Ecognize/uavprobe/hw/uavprobe/uavprobe.kicad_pcb

## KiCad design hw/uavprobe/uavprobe.kicad_pcb (2025-10-03)

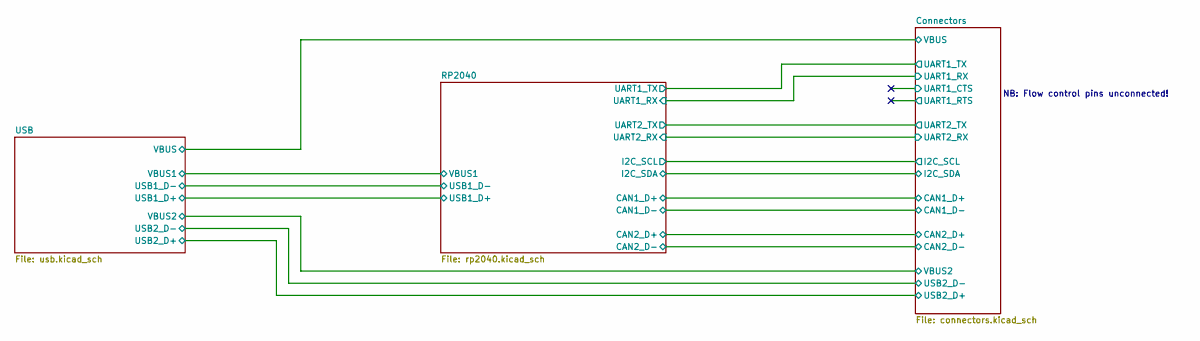
[picture p1: schematic uavprobe.kicad_sch, UAV Sensor Probe]

Notes on the sheet:
NB: Flow control pins unconnected!

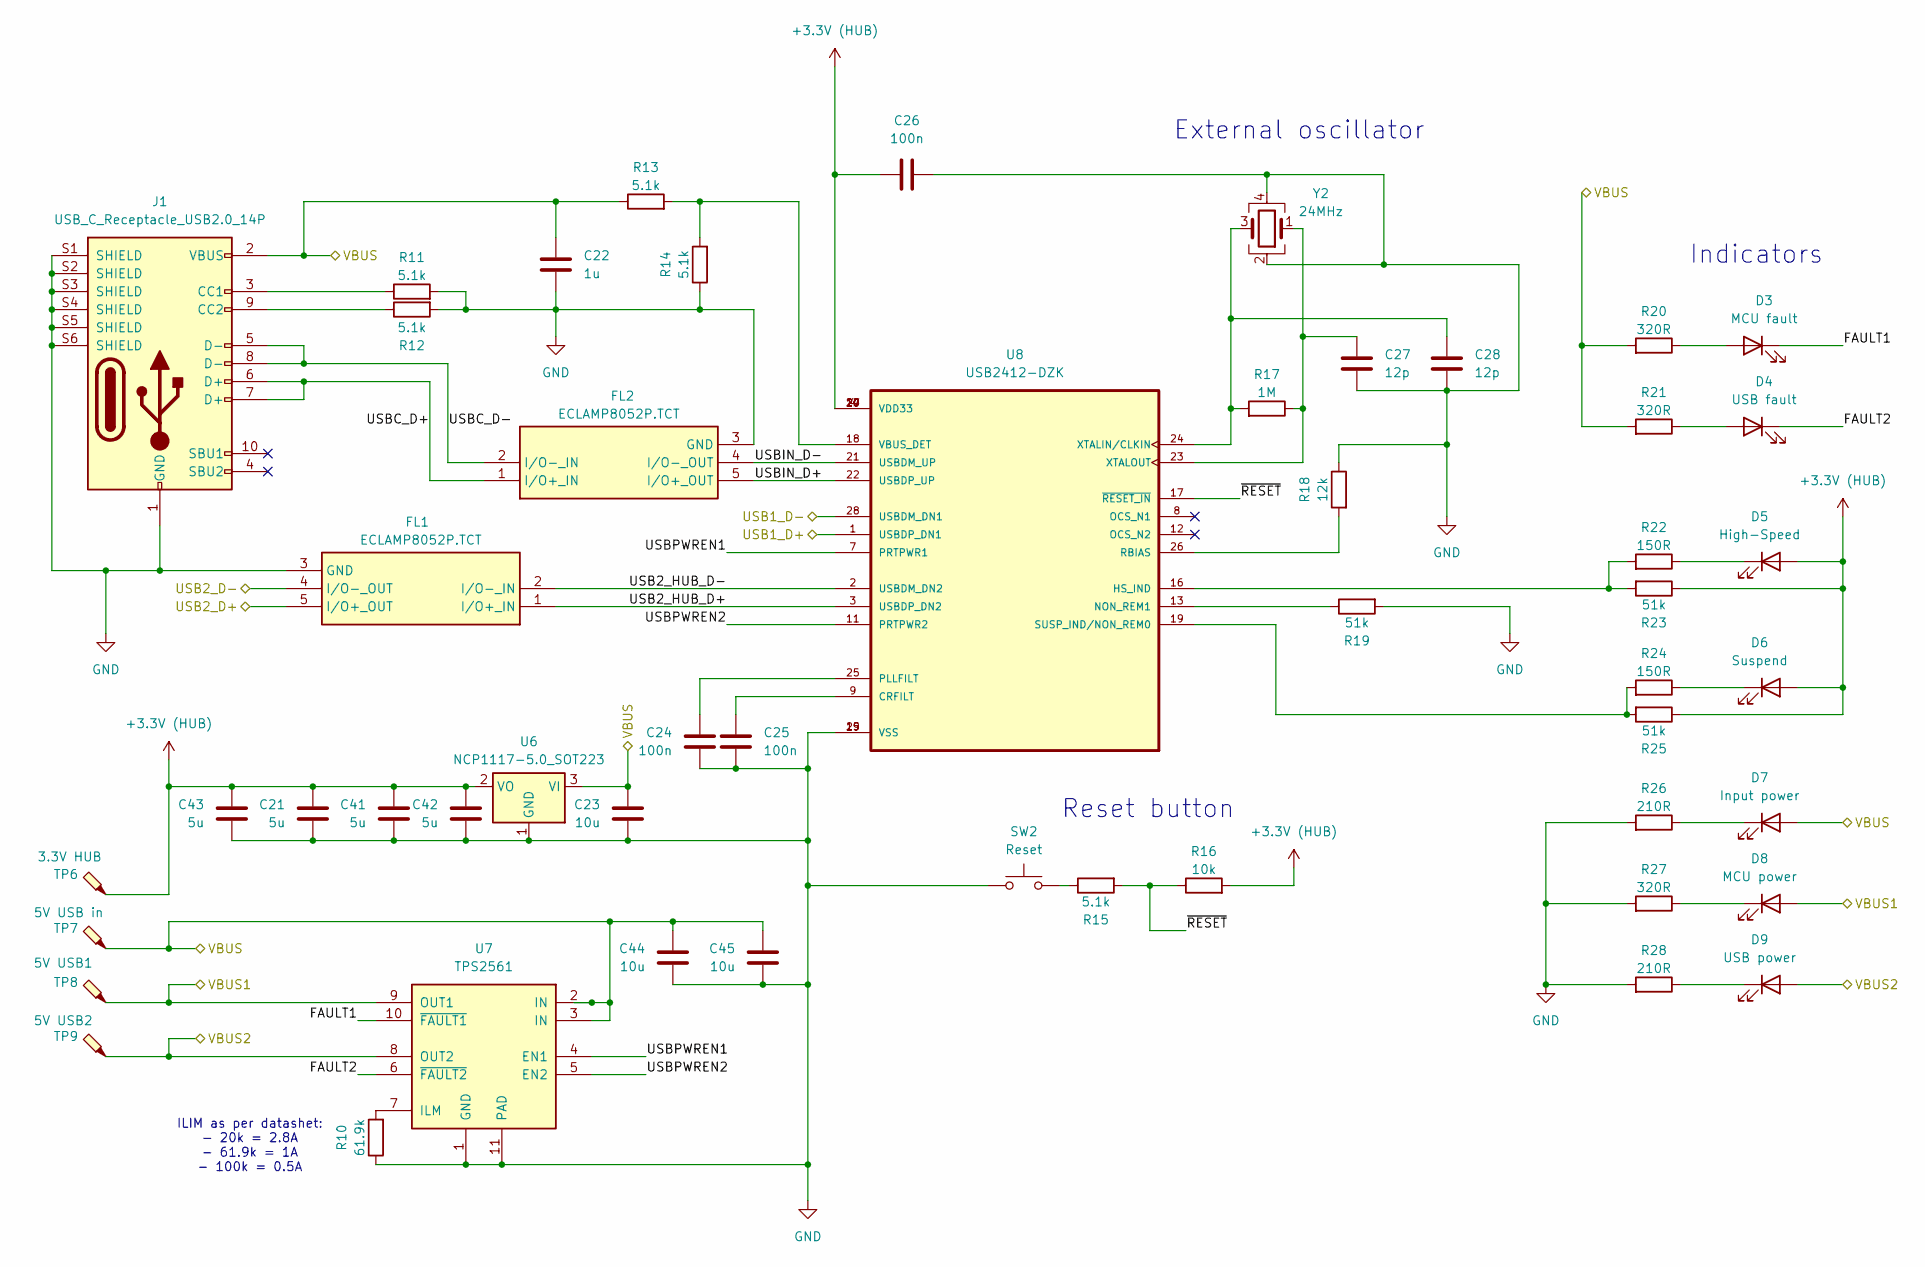
[picture p2: schematic usb.kicad_sch, UAV Sensor Probe]

Parts:
C21, C41, C42, C43: 5u; C_0402_1005Metric
C22: 1u; C_0402_1005Metric
C23, C44, C45: 10u; C_0402_1005Metric
C24, C25, C26: 100n; C_0402_1005Metric
C27, C28: 12p; C_0402_1005Metric
D3: MCU fault; LED_0402_1005Metric; MPN QBLP595-R
D4: USB fault; LED_0402_1005Metric; MPN QBLP595-R
D5: High-Speed; LED_0402_1005Metric; MPN QBLP595-O
D6: Suspend; LED_0402_1005Metric; MPN QBLP595-Y
D7: Input power; LED_0402_1005Metric; MPN QBLP595-IG
D8: MCU power; LED_0402_1005Metric; MPN QBLP595-AG
D9: USB power; LED_0402_1005Metric; MPN QBLP595-IB
FL1, FL2: ECLAMP8052P.TCT; ECLAMP8052PTCT; MPN ECLAMP8052P.TCT; Mouser Part Number 947-ECLAMP8052P.TCT
J1: USB_C_Receptacle_USB2.0_14P; JAE_DX07S016JA1R1500; MPN DX07S016JA1R1500
R10: 61.9k; R_0402_1005Metric
R11, R12, R13, R14, R15: 5.1k; R_0402_1005Metric
R16: 10k; R_0402_1005Metric
R17: 1M; R_0402_1005Metric
R18: 12k; R_0402_1005Metric
R19, R23, R25: 51k; R_0402_1005Metric
R20, R21, R27: 320R; R_0402_1005Metric
R22, R24: 150R; R_0402_1005Metric
R26, R28: 210R; R_0402_1005Metric
SW2: Reset; SW_SPST_B3U-1000P; MPN B3U-1000PM
TP6: 3.3V HUB; TestPoint_Pad_D1.5mm
TP7: 5V USB in; TestPoint_Pad_D1.5mm
TP8: 5V USB1; TestPoint_Pad_D1.5mm
TP9: 5V USB2; TestPoint_Pad_D1.5mm
U6: NCP1117-5.0_SOT223; SOT-223-3_TabPin2; MPN NCP1117ST33T3G
U7: TPS2561; VSON-10-1EP_3x3mm_P0.5mm_EP1.65x2.4mm_ThermalVias; MPN TPS2561DRCT
U8: USB2412-DZK; QFN50P500X500X100-29N; MPN USB2412-DZK; DIGI-KEY_PART_NUMBER 638-1114-ND
Y2: 24MHz; Crystal_SMD_Abracon_ABM3B-4Pin_5.0x3.2mm; MPN ABM3B-24.000MHZ-10-1-U-T

Connections:
+3.3V (HUB): C21.1, C26.1, C41.1, C42.1, C43.1, D5.2 (A), D6.2 (A), R16.2, R23.1, R25.1, TP6.1, U6.2 (VO), U8.4 (VDD33), U8.10 (VDD33), U8.14 (VDD33), U8.20 (VDD33), U8.27 (VDD33)
/Connectors/USB2_D+: FL1.5 (I/O+_OUT); also elsewhere on the board
/Connectors/USB2_D-: FL1.4 (I/O-_OUT); also elsewhere on the board
/Connectors/VBUS: C22.1, C23.1, C44.1, C45.1, D7.2 (A), J1.2 (VBUS), J1.11 (VBUS), R13.1, R20.2, R21.2, TP7.1, U6.3 (VI), U7.2 (IN), U7.3 (IN); also elsewhere on the board
/Connectors/VBUS2: D9.2 (A), TP9.1, U7.8 (OUT2); also elsewhere on the board
/RP2040/USB1_D+: U8.1 (USBDP_DN1); also elsewhere on the board
/RP2040/USB1_D-: U8.28 (USBDM_DN1); also elsewhere on the board
/RP2040/VBUS1: D8.2 (A), TP8.1, U7.9 (OUT1); also elsewhere on the board
/USB/FAULT1: D3.1 (K), U7.10 (~FAULT1)
/USB/FAULT2: D4.1 (K), U7.6 (~FAULT2)
/USB/USB2_HUB_D+: FL1.1 (I/O+_IN), U8.3 (USBDP_DN2)
/USB/USB2_HUB_D-: FL1.2 (I/O-_IN), U8.2 (USBDM_DN2)
/USB/USBC_D+: FL2.1 (I/O+_IN), J1.6 (D+), J1.7 (D+)
/USB/USBC_D-: FL2.2 (I/O-_IN), J1.5 (D-), J1.8 (D-)
/USB/USBIN_D+: FL2.5 (I/O+_OUT), U8.22 (USBDP_UP)
/USB/USBIN_D-: FL2.4 (I/O-_OUT), U8.21 (USBDM_UP)
/USB/USBPWREN1: U7.4 (EN1), U8.7 (PRTPWR1)
/USB/USBPWREN2: U7.5 (EN2), U8.11 (PRTPWR2)
/USB/~RESET: R15.2, R16.1, U8.17 (~RESET_IN)
GND: C21.2, C22.2, C23.2, C24.2, C25.2, C26.2, C27.2, C28.2, C41.2, C42.2, C43.2, C44.2, C45.2, FL1.3 (GND), FL2.3 (GND), J1.1 (GND), J1.12 (GND), J1.S1 (SHIELD), J1.S2 (SHIELD), J1.S3 (SHIELD), J1.S4 (SHIELD), J1.S5 (SHIELD), J1.S6 (SHIELD), R10.1, R11.2, R12.2, R14.1, R18.1, R19.2, R26.2, R27.2, R28.2, SW2.1, U6.1 (GND), U7.1 (GND), U7.11 (PAD), U8.15 (VSS), U8.29 (VSS), Y2.2, Y2.4; also elsewhere on the board
unnamed: D3.2 (A), R20.1
unnamed: D4.2 (A), R21.1
unnamed: D5.1 (K), R22.1
unnamed: D6.1 (K), R24.1
unnamed: D7.1 (K), R26.1
unnamed: D8.1 (K), R27.1
unnamed: D9.1 (K), R28.1
unnamed: J1.3 (CC1), R11.1
unnamed: J1.9 (CC2), R12.1
unnamed: R15.1, SW2.2
unnamed: R10.2, U7.7 (ILM)
unnamed: C25.1, U8.9 (CRFILT)
unnamed: R22.2, R23.2, U8.16 (HS_IND)
unnamed: R19.1, U8.13 (NON_REM1)
unnamed: C24.1, U8.25 (PLLFILT)
unnamed: R18.2, U8.26 (RBIAS)
unnamed: R24.2, R25.2, U8.19 (SUSP_IND/NON_REM0)
unnamed: R13.2, R14.2, U8.18 (VBUS_DET)
unnamed: C28.1, R17.2, U8.24 (XTALIN/CLKIN), Y2.3
unnamed: C27.1, R17.1, U8.23 (XTALOUT), Y2.1

Notes on the sheet:
Indicators
ILIM as per datashet: - 20k = 2.8A - 61.9k = 1A - 100k = 0.5A
Reset button
External oscillator

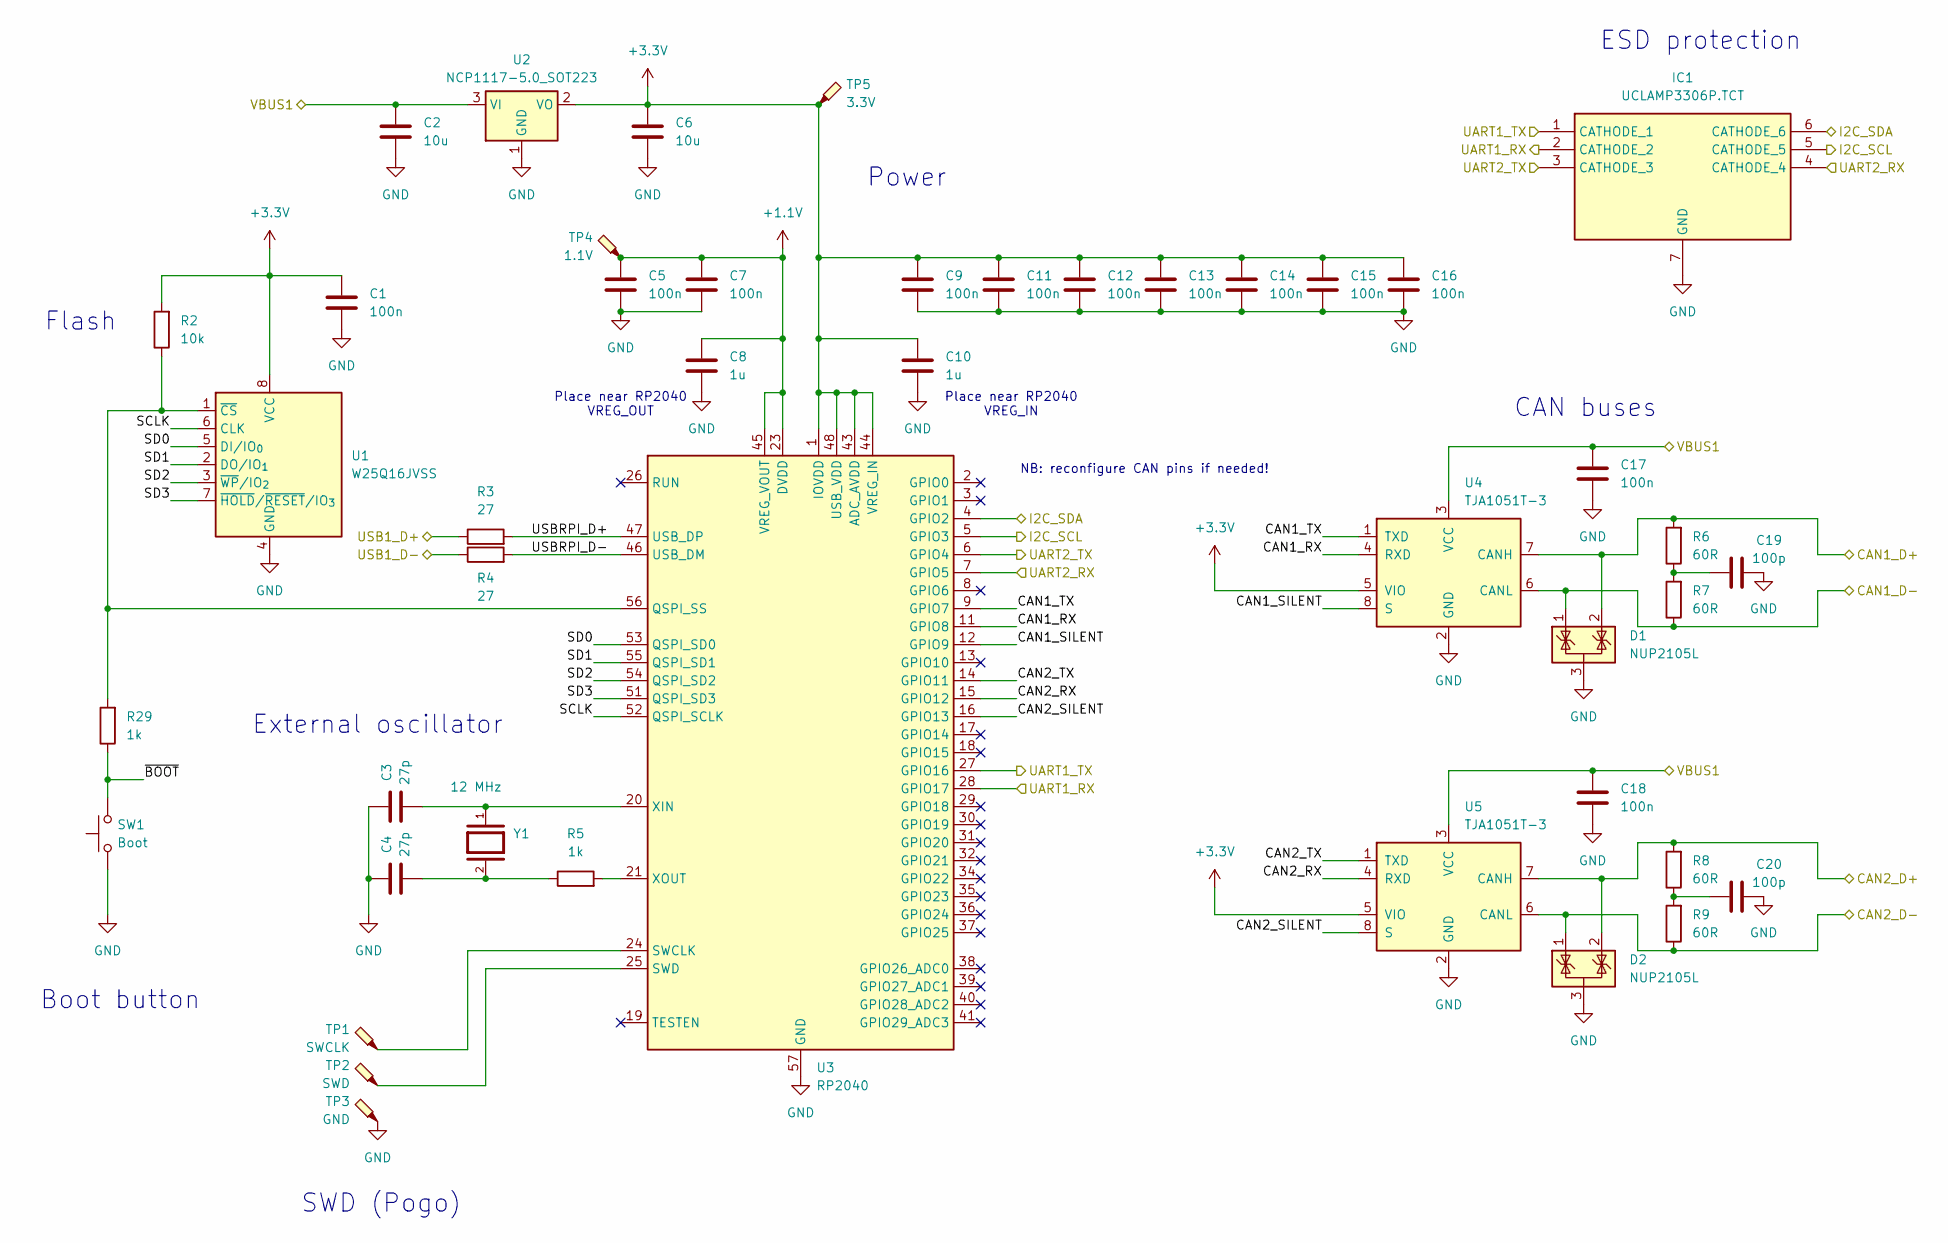
[picture p3: schematic rp2040.kicad_sch, UAV Sensor Probe]

Parts:
C1, C5, C7, C9, C11, C12, C13, C14, C15, C16, C17, C18: 100n; C_0402_1005Metric
C2, C6: 10u; C_0402_1005Metric
C3, C4: 27p; C_0402_1005Metric
C8, C10: 1u; C_0402_1005Metric
C19, C20: 100p; C_0402_1005Metric
D1, D2: NUP2105L; SOT-23; MPN NUP2105L
IC1: UCLAMP3306P.TCT; SON50P160X160X65-7N; MPN UCLAMP3306P.TCT; Mouser Part Number 947-UCLAMP3306P.TCT
R2: 10k; R_0402_1005Metric
R3: 27; R_0603_1608Metric
R4: 27; R_0402_1005Metric
R5, R29: 1k; R_0402_1005Metric
R6, R7, R8, R9: 60R; R_0402_1005Metric
SW1: Boot; SW_SPST_B3U-1000P; MPN B3U-1000PM
TP1: SWCLK; TestPoint_Pad_D1.5mm
TP2: SWD; TestPoint_Pad_D1.5mm
TP3: GND; TestPoint_Pad_D1.5mm
TP4: 1.1V; TestPoint_Pad_D1.5mm
TP5: 3.3V; TestPoint_Pad_D1.5mm
U1: W25Q16JVSS; SOIC-8_5.3x5.3mm_P1.27mm; MPN W25Q16JVSSIQ
U2: NCP1117-5.0_SOT223; SOT-223-3_TabPin2; MPN NCP1117ST33T3G
U3: RP2040; QFN-56-1EP_7x7mm_P0.4mm_EP3.2x3.2mm_ThermalVias; MPN SC0914(7)
U4, U5: TJA1051T-3; SOIC-8_3.9x4.9mm_P1.27mm; MPN TJA1051T/3/1J
Y1: 12 MHz; XTAL_ABLS-12.000MHZ-B4-T; PARTREV 02.16.2021

Connections:
+1.1V: C5.1, C7.1, C8.1, TP4.1, U3.23 (DVDD), U3.45 (VREG_VOUT), U3.50 (DVDD)
+3.3V: C1.1, C6.1, C9.1, C10.1, C11.1, C12.1, C13.1, C14.1, C15.1, C16.1, R2.2, TP5.1, U1.8 (VCC), U2.2 (VO), U3.1 (IOVDD), U3.10 (IOVDD), U3.22 (IOVDD), U3.33 (IOVDD), U3.42 (IOVDD), U3.43 (ADC_AVDD), U3.44 (VREG_IN), U3.48 (USB_VDD), U3.49 (IOVDD), U4.5 (VIO), U5.5 (VIO)
/Connectors/CAN1_D+: D1.2 (K), R6.2, U4.7 (CANH); also elsewhere on the board
/Connectors/CAN1_D-: D1.1 (K), R7.1, U4.6 (CANL); also elsewhere on the board
/Connectors/CAN2_D+: D2.2 (K), R8.2, U5.7 (CANH); also elsewhere on the board
/Connectors/CAN2_D-: D2.1 (K), R9.1, U5.6 (CANL); also elsewhere on the board
/Connectors/I2C_SCL: IC1.5 (CATHODE_5), U3.5 (GPIO3); also elsewhere on the board
/Connectors/I2C_SDA: IC1.6 (CATHODE_6), U3.4 (GPIO2); also elsewhere on the board
/Connectors/UART1_RX: IC1.2 (CATHODE_2), U3.28 (GPIO17); also elsewhere on the board
/Connectors/UART1_TX: IC1.1 (CATHODE_1), U3.27 (GPIO16); also elsewhere on the board
/Connectors/UART2_RX: IC1.4 (CATHODE_4), U3.7 (GPIO5); also elsewhere on the board
/Connectors/UART2_TX: IC1.3 (CATHODE_3), U3.6 (GPIO4); also elsewhere on the board
/RP2040/CAN1_RX: U3.11 (GPIO8), U4.4 (RXD)
/RP2040/CAN1_SILENT: U3.12 (GPIO9), U4.8 (S)
/RP2040/CAN1_TX: U3.9 (GPIO7), U4.1 (TXD)
/RP2040/CAN2_RX: U3.15 (GPIO12), U5.4 (RXD)
/RP2040/CAN2_SILENT: U3.16 (GPIO13), U5.8 (S)
/RP2040/CAN2_TX: U3.14 (GPIO11), U5.1 (TXD)
/RP2040/SCLK: U1.6 (CLK), U3.52 (QSPI_SCLK)
/RP2040/SD0: U1.5 (DI/IO_{0}), U3.53 (QSPI_SD0)
/RP2040/SD1: U1.2 (DO/IO_{1}), U3.55 (QSPI_SD1)
/RP2040/SD2: U1.3 (~WP/IO_{2}), U3.54 (QSPI_SD2)
/RP2040/SD3: U1.7 (~HOLD/~RESET/IO_{3}), U3.51 (QSPI_SD3)
/RP2040/USB1_D+: R3.1; also elsewhere on the board
/RP2040/USB1_D-: R4.1; also elsewhere on the board
/RP2040/USBRPI_D+: R3.2, U3.47 (USB_DP)
/RP2040/USBRPI_D-: R4.2, U3.46 (USB_DM)
/RP2040/VBUS1: C2.1, C17.1, C18.1, U2.3 (VI), U4.3 (VCC), U5.3 (VCC); also elsewhere on the board
/RP2040/~BOOT: R29.1, SW1.2
GND: C1.2, C2.2, C3.1, C4.1, C5.2, C6.2, C7.2, C8.2, C9.2, C10.2, C11.2, C12.2, C13.2, C14.2, C15.2, C16.2, C17.2, C18.2, C19.1, C20.1, D1.3 (A), D2.3 (A), IC1.7 (GND), SW1.1, TP3.1, U1.4 (GND), U2.1 (GND), U3.57 (GND), U4.2 (GND), U5.2 (GND); also elsewhere on the board
unnamed: C4.2, R5.1, Y1.2
unnamed: C19.2, R6.1, R7.2
unnamed: C20.2, R8.1, R9.2
unnamed: R2.1, R29.2, U1.1 (~CS), U3.56 (QSPI_SS)
unnamed: TP1.1, U3.24 (SWCLK)
unnamed: TP2.1, U3.25 (SWD)
unnamed: C3.2, U3.20 (XIN), Y1.1
unnamed: R5.2, U3.21 (XOUT)

Notes on the sheet:
Power
Place near RP2040 VREG_OUT
ESD protection
CAN buses
Flash
Place near RP2040 VREG_IN
NB: reconfigure CAN pins if needed!
Boot button
SWD (Pogo)
External oscillator

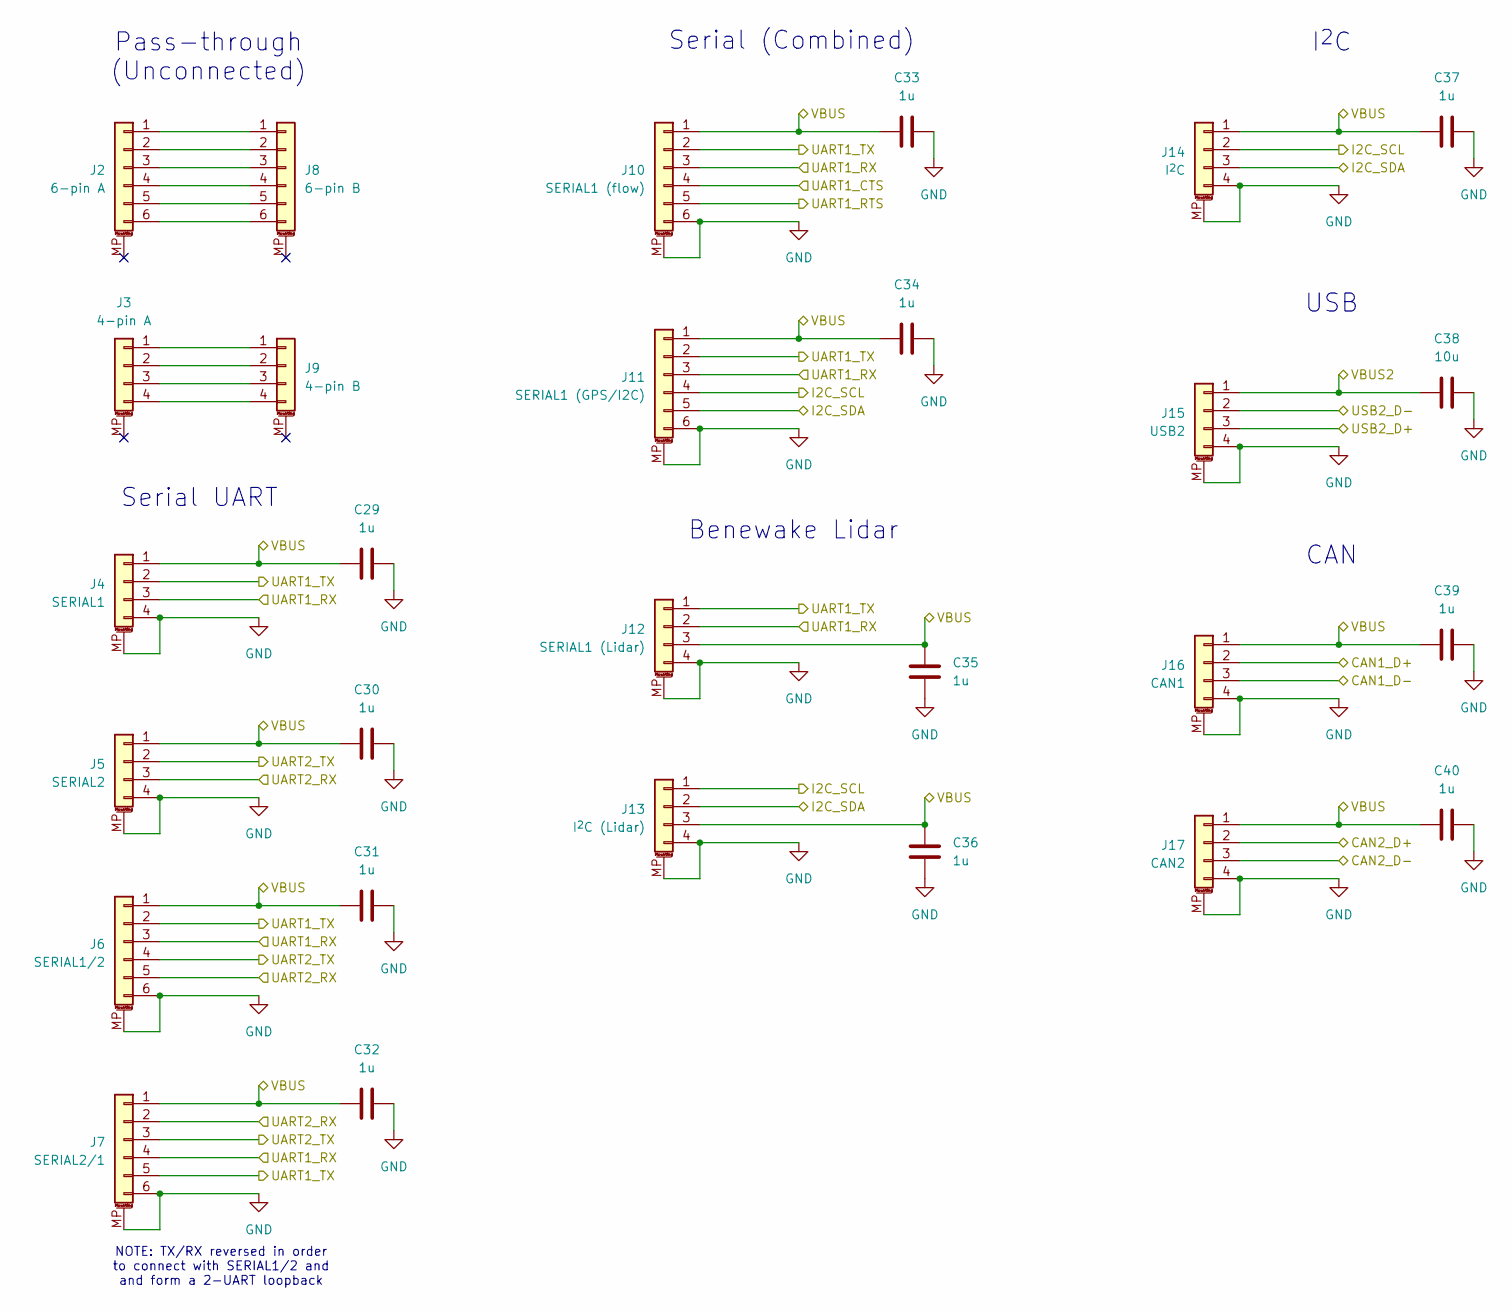
[picture p4: schematic connectors.kicad_sch, UAV Sensor Probe]

Parts:
C29, C30, C31, C32, C33, C34, C35, C36, C37, C39, C40: 1u; C_0402_1005Metric
C38: 10u; C_0402_1005Metric
J2: 6-pin A; JST_GH_BM06B-GHS-TBT_1x06-1MP_P1.25mm_Vertical; MPN BM06B-GHS-TBT
J3: 4-pin A; JST_GH_BM04B-GHS-TBT_1x04-1MP_P1.25mm_Vertical; MPN BM04B-GHS-TBT
J4: SERIAL1; JST_GH_BM04B-GHS-TBT_1x04-1MP_P1.25mm_Vertical; MPN BM04B-GHS-TBT
J5: SERIAL2; JST_GH_BM04B-GHS-TBT_1x04-1MP_P1.25mm_Vertical; MPN BM04B-GHS-TBT
J6: SERIAL1/2; JST_GH_BM06B-GHS-TBT_1x06-1MP_P1.25mm_Vertical; MPN BM06B-GHS-TBT
J7: SERIAL2/1; JST_GH_BM06B-GHS-TBT_1x06-1MP_P1.25mm_Vertical; MPN BM06B-GHS-TBT
J8: 6-pin B; JST_GH_BM06B-GHS-TBT_1x06-1MP_P1.25mm_Vertical; MPN BM06B-GHS-TBT
J9: 4-pin B; JST_GH_BM04B-GHS-TBT_1x04-1MP_P1.25mm_Vertical; MPN BM04B-GHS-TBT
J10: SERIAL1 (flow); JST_GH_BM06B-GHS-TBT_1x06-1MP_P1.25mm_Vertical; MPN BM06B-GHS-TBT
J11: SERIAL1 (GPS/I2C); JST_GH_BM06B-GHS-TBT_1x06-1MP_P1.25mm_Vertical; MPN BM06B-GHS-TBT
J12: SERIAL1 (Lidar); JST_GH_BM04B-GHS-TBT_1x04-1MP_P1.25mm_Vertical; MPN BM04B-GHS-TBT
J13: I^{2}C (Lidar); JST_GH_BM04B-GHS-TBT_1x04-1MP_P1.25mm_Vertical; MPN BM04B-GHS-TBT
J14: I^{2}C; JST_GH_BM04B-GHS-TBT_1x04-1MP_P1.25mm_Vertical; MPN BM04B-GHS-TBT
J15: USB2; JST_GH_BM04B-GHS-TBT_1x04-1MP_P1.25mm_Vertical; MPN BM04B-GHS-TBT
J16: CAN1; JST_GH_BM04B-GHS-TBT_1x04-1MP_P1.25mm_Vertical; MPN BM04B-GHS-TBT
J17: CAN2; JST_GH_BM04B-GHS-TBT_1x04-1MP_P1.25mm_Vertical; MPN BM04B-GHS-TBT

Connections:
/Connectors/CAN1_D+: J16.2; also elsewhere on the board
/Connectors/CAN1_D-: J16.3; also elsewhere on the board
/Connectors/CAN2_D+: J17.2; also elsewhere on the board
/Connectors/CAN2_D-: J17.3; also elsewhere on the board
/Connectors/I2C_SCL: J11.4, J13.1, J14.2; also elsewhere on the board
/Connectors/I2C_SDA: J11.5, J13.2, J14.3; also elsewhere on the board
/Connectors/UART1_CTS: J10.4
/Connectors/UART1_RTS: J10.5
/Connectors/UART1_RX: J4.3, J6.3, J7.4, J10.3, J11.3, J12.2; also elsewhere on the board
/Connectors/UART1_TX: J4.2, J6.2, J7.5, J10.2, J11.2, J12.1; also elsewhere on the board
/Connectors/UART2_RX: J5.3, J6.5, J7.2; also elsewhere on the board
/Connectors/UART2_TX: J5.2, J6.4, J7.3; also elsewhere on the board
/Connectors/USB2_D+: J15.3; also elsewhere on the board
/Connectors/USB2_D-: J15.2; also elsewhere on the board
/Connectors/VBUS: C29.1, C30.1, C31.1, C32.1, C33.1, C34.1, C35.2, C36.2, C37.1, C39.1, C40.1, J4.1, J5.1, J6.1, J7.1, J10.1, J11.1, J12.3, J13.3, J14.1, J16.1, J17.1; also elsewhere on the board
/Connectors/VBUS2: C38.1, J15.1; also elsewhere on the board
GND: C29.2, C30.2, C31.2, C32.2, C33.2, C34.2, C35.1, C36.1, C37.2, C38.2, C39.2, C40.2, J4.4, J4.MP (MountPin), J5.4, J5.MP (MountPin), J6.6, J6.MP (MountPin), J7.6, J7.MP (MountPin), J10.6, J10.MP (MountPin), J11.6, J11.MP (MountPin), J12.4, J12.MP (MountPin), J13.4, J13.MP (MountPin), J14.4, J14.MP (MountPin), J15.4, J15.MP (MountPin), J16.4, J16.MP (MountPin), J17.4, J17.MP (MountPin); also elsewhere on the board
unnamed: J2.1, J8.1
unnamed: J2.2, J8.2
unnamed: J2.3, J8.3
unnamed: J2.4, J8.4
unnamed: J2.5, J8.5
unnamed: J2.6, J8.6
unnamed: J3.1, J9.1
unnamed: J3.2, J9.2
unnamed: J3.3, J9.3
unnamed: J3.4, J9.4

Notes on the sheet:
USB
Serial (Combined)
Benewake Lidar
Pass-through (Unconnected)
Serial UART
I^{2}C
NOTE: TX/RX reversed in order to connect with SERIAL1/2 and and form a 2-UART loopback
CAN

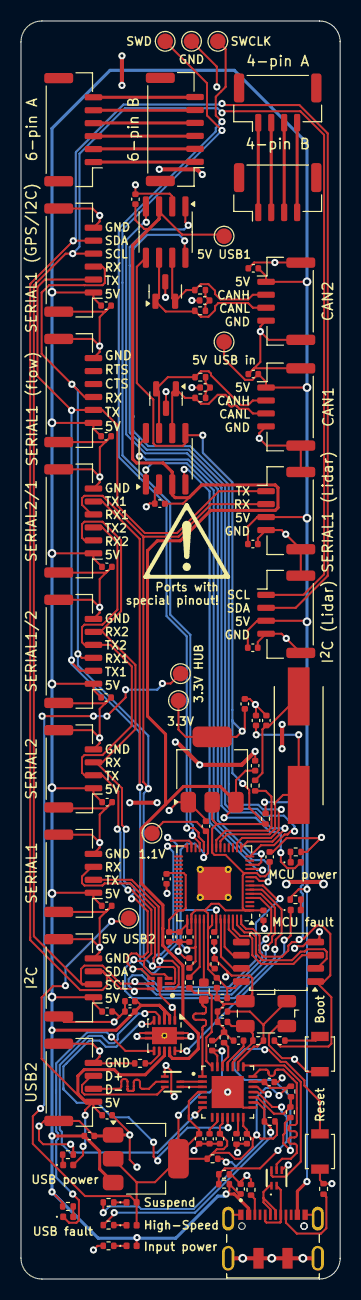
[picture p5: board uavprobe.kicad_pcb from above]

Board: 2 copper layers, 30.8 x 121.4 mm, 123 parts (0 on the bottom side), 84 nets.
