Ecognize/uavprobe/(commit log)

2025-08-24 AISLER from template
    2 layer HASL
    [uavprobe.kicad_pcb, uavprobe.kicad_sch, uavprobe.sch]
2025-08-26 RP2040 sheet
    [can.kicad_sch, connectors.kicad_sch, rp2040.kicad_sch, uavprobe.kicad_pcb, uavprobe.kicad_sch, usb.kicad_sch]
2025-08-26 Connectors sheet and CAN/ESD
    [connectors.kicad_sch, rp2040.kicad_sch, uavprobe.kicad_sch]
2025-08-26 CAN ESD protection
    [rp2040.kicad_sch]
2025-08-26 USB sheet
    [connectors.kicad_sch, rp2040.kicad_sch, usb.kicad_sch]
2025-08-26 Cleanup and root sheet
    [connectors.kicad_sch, rp2040.kicad_sch, uavprobe.kicad_sch, usb.kicad_sch]
2025-08-26 Power test points
    [connectors.kicad_sch, usb.kicad_sch]
2025-08-26 ERC pass
    Footprint and symbol copy editing warnings left
    [connectors.kicad_sch, rp2040.kicad_sch, uavprobe.kicad_sch, usb.kicad_sch]
2025-08-27 Footprint/MPN assignment pass
    [connectors.kicad_sch, rp2040.kicad_sch, usb.kicad_sch]
2025-08-27 Components import and model setup
    [uavprobe.kicad_pcb]
2025-08-28 Design rules and net classes
    [uavprobe.kicad_pcb, usb.kicad_sch]
2025-08-29 Training layout
    Lessons were learned, let's restart.
    [rp2040.kicad_sch, uavprobe.kicad_pcb, usb.kicad_sch]
2025-08-30 Layout revision 1
    Pre-DRC
    [connectors.kicad_sch, rp2040.kicad_sch, uavprobe.kicad_pcb, usb.kicad_sch]
2025-08-30 AISLER-friendly BOM fields
    [rp2040.kicad_sch, usb.kicad_sch]
2025-08-31 3D models fix for imported components
    [uavprobe.kicad_pcb]
2025-09-01 Official AISLER HASL 2-layer rules
    [uavprobe.kicad_pcb]
2025-09-05 Layout 2
    Honoring the DRC and with a new uSB-C connector
    [rp2040.kicad_sch, uavprobe.kicad_pcb, usb.kicad_sch]
2025-09-05 Edge cleaning
    [uavprobe.kicad_pcb]
2025-09-06 USB-C connector 3D model
    [uavprobe.kicad_pcb]
2025-09-06 Back silkscreen
    [uavprobe.kicad_pcb, uavprobe.kicad_sch]
2025-09-06 USB-C connector change
    [uavprobe.kicad_pcb, usb.kicad_sch]
2025-10-03 LEDs reconfigured for 10 mA current
    [uavprobe.kicad_pcb, usb.kicad_sch]
